NaisuXu/NUC980DKxxYx_Development_Board/NUC980DKxxYx_Development_Board.kicad_pcb

## KiCad design NUC980DKxxYx_Development_Board.kicad_pcb (2023-09-10)

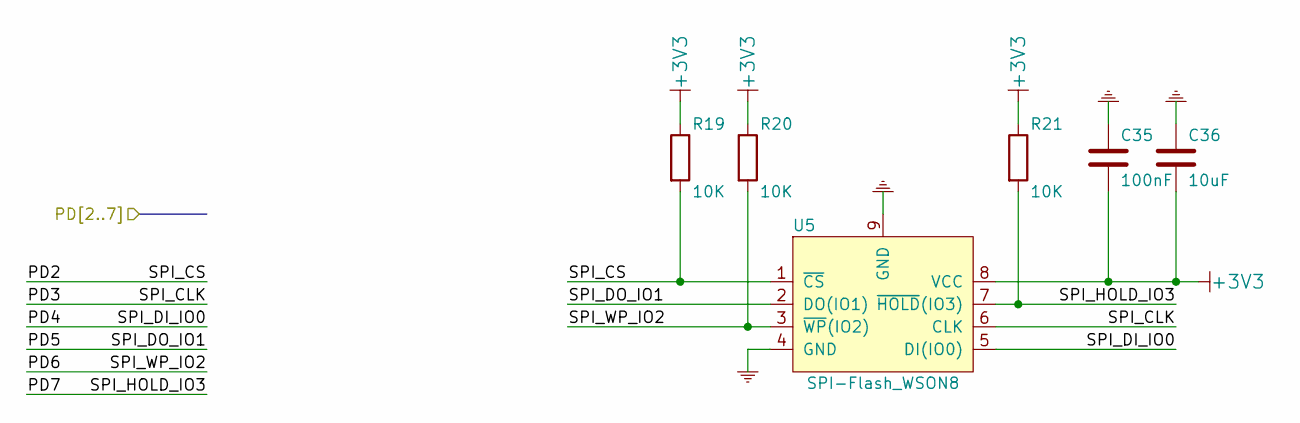
[picture p3: schematic SPI_Flash.kicad_sch]

Parts:
C35: 100nF; C_0603_1608Metric
C36: 10uF; C_0805_2012Metric
R19, R20, R21: 10K; R_0603_1608Metric
U5: SPI-Flash_WSON8; WSON-8-1EP_8x6mm_P1.27mm_EP3.4x4.3mm

Connections:
+3V3: C35.2, C36.2, R19.1, R20.1, R21.1, U5.8 (VCC); also elsewhere on the board
/PD2: R19.2, U5.1 (~CS); also elsewhere on the board
/PD3: U5.6 (CLK); also elsewhere on the board
/PD4: U5.5 (DI(IO0)); also elsewhere on the board
/PD5: U5.2 (DO(IO1)); also elsewhere on the board
/PD6: R20.2, U5.3 (~WP(IO2)); also elsewhere on the board
/PD7: R21.2, U5.7 (~HOLD(IO3)); also elsewhere on the board
GND: C35.1, C36.1, U5.4 (GND), U5.9 (GND); also elsewhere on the board

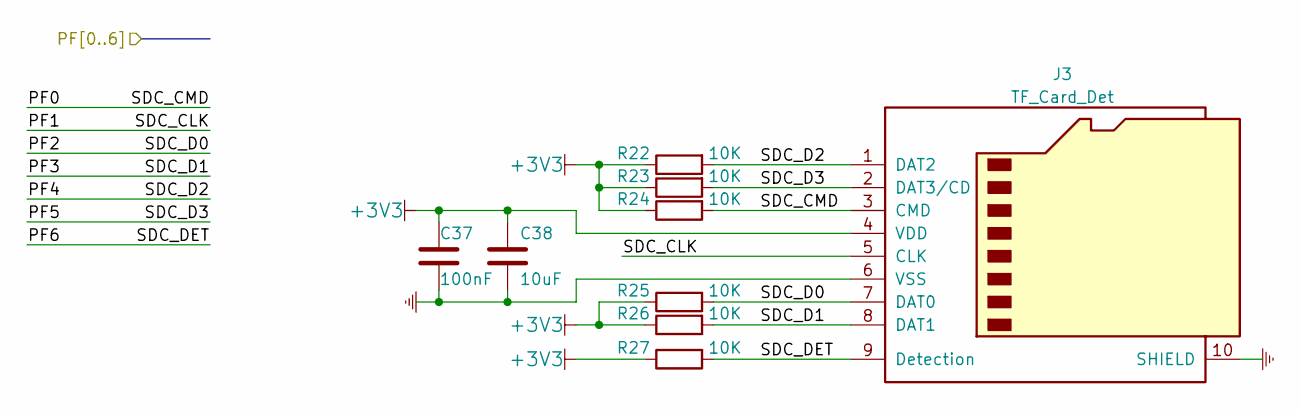
[picture p4: schematic SD_Card.kicad_sch]

Parts:
C37: 100nF; C_0603_1608Metric
C38: 10uF; C_0805_2012Metric
J3: TF_Card_Det; microSD_Push-Push_9P_4Pad
R22, R23, R24, R25, R26, R27: 10K; R_0603_1608Metric

Connections:
+3V3: C37.1, C38.1, J3.4 (VDD), R22.1, R23.1, R24.1, R25.1, R26.1, R27.1; also elsewhere on the board
/PF0: J3.3 (CMD), R24.2; also elsewhere on the board
/PF1: J3.5 (CLK); also elsewhere on the board
/PF2: J3.7 (DAT0), R25.2; also elsewhere on the board
/PF3: J3.8 (DAT1), R26.2; also elsewhere on the board
/PF4: J3.1 (DAT2), R22.2; also elsewhere on the board
/PF5: J3.2 (DAT3/CD), R23.2; also elsewhere on the board
/PF6: J3.9 (Detection), R27.2; also elsewhere on the board
GND: C37.2, C38.2, J3.6 (VSS), J3.10 (SHIELD); also elsewhere on the board

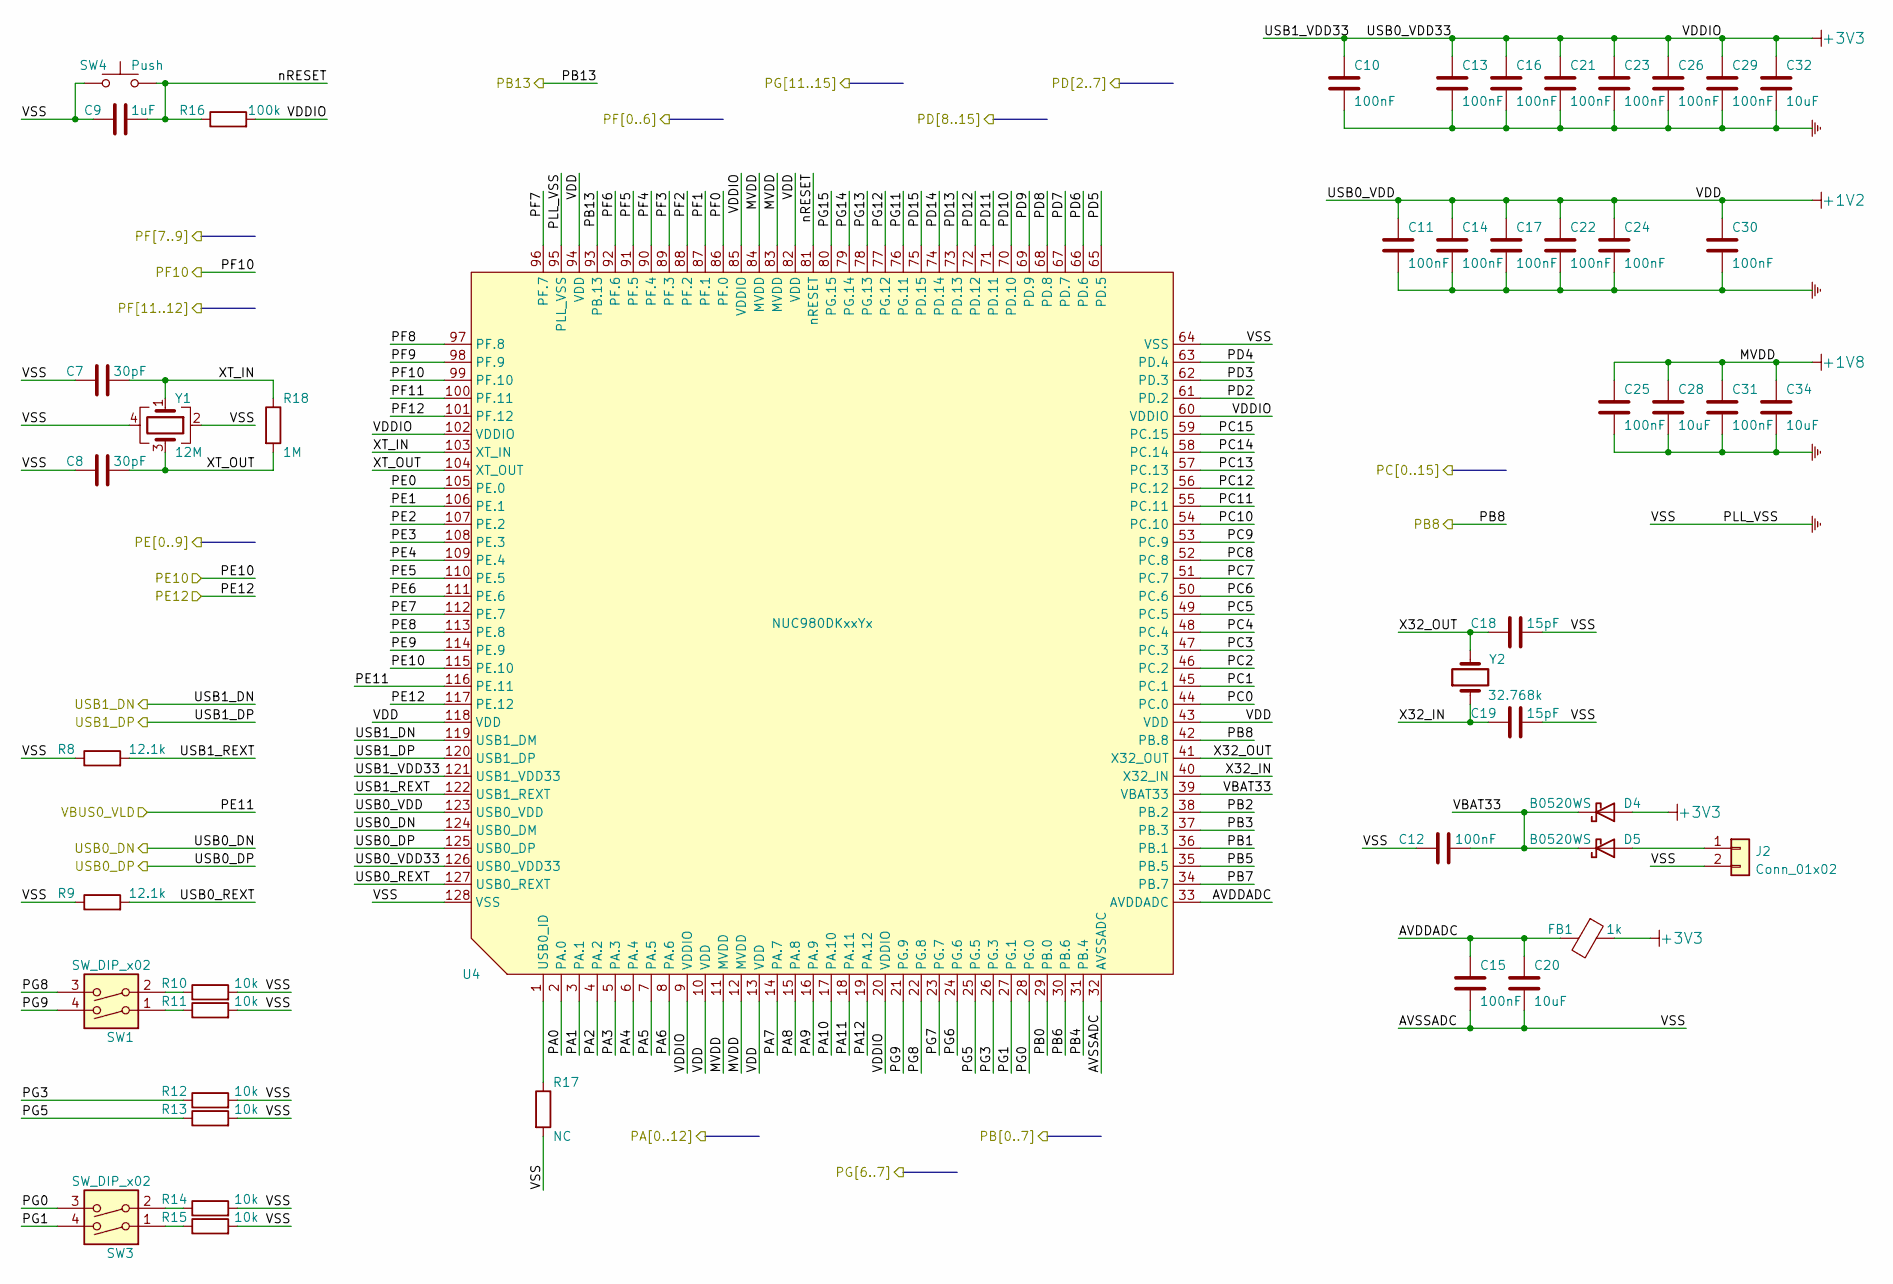
[picture p5: schematic MPU.kicad_sch]

Parts:
C7, C8: 30pF; C_0603_1608Metric
C9: 1uF; C_0603_1608Metric
C10, C11, C12, C13, C14, C15, C16, C17, C21, C22, C23, C24, C25, C26, C29, C30, C31: 100nF; C_0603_1608Metric
C18, C19: 15pF; C_0603_1608Metric
C20, C28, C32, C34: 10uF; C_0805_2012Metric
D4, D5: B0520WS; D_SOD-323
FB1: 1k; L_0603_1608Metric
J2: Conn_01x02; PinHeader_1x02_P2.54mm_Vertical
R8, R9: 12.1k; R_0603_1608Metric
R10, R11, R12, R13, R14, R15: 10k; R_0603_1608Metric
R16: 100k; R_0603_1608Metric
R17: NC; R_0603_1608Metric
R18: 1M; R_0603_1608Metric
SW1, SW3: SW_DIP_x02; SW_DIP_SPSTx02_Slide_9.78x7.26mm_W7.62mm_P2.54mm
SW4: Push; SW_SPST_CK_RS282G05A3
U4: NUC980DKxxYx; LQFP-128_14x14mm_P0.4mm
Y1: 12M; Crystal_SMD_3225-4Pin_3.2x2.5mm
Y2: 32.768k; Crystal_SMD_3215-2Pin_3.2x1.5mm

Connections:
+1V2: C11.1, C14.1, C17.1, C22.1, C24.1, C30.1, U4.10 (VDD), U4.13 (VDD), U4.43 (VDD), U4.82 (VDD), U4.94 (VDD), U4.118 (VDD), U4.123 (USB0_VDD); also elsewhere on the board
+1V8: C25.1, C28.1, C31.1, C34.1, U4.11 (MVDD), U4.12 (MVDD), U4.83 (MVDD), U4.84 (MVDD); also elsewhere on the board
+3V3: C10.1, C13.1, C16.1, C21.1, C23.1, C26.1, C29.1, C32.1, D4.2 (A), FB1.1, R16.2, U4.9 (VDDIO), U4.20 (VDDIO), U4.60 (VDDIO), U4.85 (VDDIO), U4.102 (VDDIO), U4.121 (USB1_VDD33), U4.126 (USB0_VDD33); also elsewhere on the board
/MPU/AVDDADC: C15.1, C20.1, FB1.2, U4.33 (AVDDADC)
/MPU/PG0: SW3.3, U4.28 (PG.0)
/MPU/PG1: SW3.4, U4.27 (PG.1)
/MPU/PG3: R12.1, U4.26 (PG.3)
/MPU/PG5: R13.1, U4.25 (PG.5)
/MPU/PG8: SW1.3, U4.22 (PG.8)
/MPU/PG9: SW1.4, U4.21 (PG.9)
/MPU/USB0_REXT: R9.2, U4.127 (USB0_REXT)
/MPU/USB1_REXT: R8.2, U4.122 (USB1_REXT)
/MPU/VBAT33: C12.2, D4.1 (K), D5.1 (K), U4.39 (VBAT33)
/MPU/X32_IN: C19.1, U4.40 (X32_IN), Y2.1
/MPU/X32_OUT: C18.1, U4.41 (X32_OUT), Y2.2
/MPU/XT_IN: C7.2, R18.1, U4.103 (XT_IN), Y1.1
/MPU/XT_OUT: C8.2, R18.2, U4.104 (XT_OUT), Y1.3
/MPU/nRESET: C9.2, R16.1, SW4.1, U4.81 (nRESET)
/PA0: U4.2 (PA.0); also elsewhere on the board
/PA1: U4.3 (PA.1); also elsewhere on the board
/PA2: U4.4 (PA.2); also elsewhere on the board
/PA3: U4.5 (PA.3); also elsewhere on the board
/PA4: U4.6 (PA.4); also elsewhere on the board
/PA5: U4.7 (PA.5); also elsewhere on the board
/PA6: U4.8 (PA.6); also elsewhere on the board
/PA7: U4.14 (PA.7); also elsewhere on the board
/PA8: U4.15 (PA.8); also elsewhere on the board
/PA9: U4.16 (PA.9); also elsewhere on the board
/PA10: U4.17 (PA.10); also elsewhere on the board
/PA11: U4.18 (PA.11); also elsewhere on the board
/PA12: U4.19 (PA.12); also elsewhere on the board
/PB0: U4.29 (PB.0); also elsewhere on the board
/PB1: U4.36 (PB.1); also elsewhere on the board
/PB2: U4.38 (PB.2); also elsewhere on the board
/PB3: U4.37 (PB.3); also elsewhere on the board
/PB4: U4.31 (PB.4); also elsewhere on the board
/PB5: U4.35 (PB.5); also elsewhere on the board
/PB6: U4.30 (PB.6); also elsewhere on the board
/PB7: U4.34 (PB.7); also elsewhere on the board
/PB8: U4.42 (PB.8); also elsewhere on the board
/PB13: U4.93 (PB.13); also elsewhere on the board
/PC0: U4.44 (PC.0); also elsewhere on the board
/PC1: U4.45 (PC.1); also elsewhere on the board
/PC2: U4.46 (PC.2); also elsewhere on the board
/PC3: U4.47 (PC.3); also elsewhere on the board
/PC4: U4.48 (PC.4); also elsewhere on the board
/PC5: U4.49 (PC.5); also elsewhere on the board
/PC6: U4.50 (PC.6); also elsewhere on the board
/PC7: U4.51 (PC.7); also elsewhere on the board
/PC8: U4.52 (PC.8); also elsewhere on the board
/PC9: U4.53 (PC.9); also elsewhere on the board
/PC10: U4.54 (PC.10); also elsewhere on the board
/PC11: U4.55 (PC.11); also elsewhere on the board
/PC12: U4.56 (PC.12); also elsewhere on the board
/PC13: U4.57 (PC.13); also elsewhere on the board
/PC14: U4.58 (PC.14); also elsewhere on the board
/PC15: U4.59 (PC.15); also elsewhere on the board
/PD2: U4.61 (PD.2); also elsewhere on the board
/PD3: U4.62 (PD.3); also elsewhere on the board
/PD4: U4.63 (PD.4); also elsewhere on the board
/PD5: U4.65 (PD.5); also elsewhere on the board
/PD6: U4.66 (PD.6); also elsewhere on the board
/PD7: U4.67 (PD.7); also elsewhere on the board
/PD8: U4.68 (PD.8); also elsewhere on the board
/PD9: U4.69 (PD.9); also elsewhere on the board
/PD10: U4.70 (PD.10); also elsewhere on the board
/PD11: U4.71 (PD.11); also elsewhere on the board
/PD12: U4.72 (PD.12); also elsewhere on the board
/PD13: U4.73 (PD.13); also elsewhere on the board
/PD14: U4.74 (PD.14); also elsewhere on the board
/PD15: U4.75 (PD.15); also elsewhere on the board
/PE0: U4.105 (PE.0); also elsewhere on the board
/PE1: U4.106 (PE.1); also elsewhere on the board
/PE2: U4.107 (PE.2); also elsewhere on the board
/PE3: U4.108 (PE.3); also elsewhere on the board
/PE4: U4.109 (PE.4); also elsewhere on the board
/PE5: U4.110 (PE.5); also elsewhere on the board
/PE6: U4.111 (PE.6); also elsewhere on the board
/PE7: U4.112 (PE.7); also elsewhere on the board
/PE8: U4.113 (PE.8); also elsewhere on the board
/PE9: U4.114 (PE.9); also elsewhere on the board
/PE10: U4.115 (PE.10); also elsewhere on the board
/PE12: U4.117 (PE.12); also elsewhere on the board
/PF0: U4.86 (PF.0); also elsewhere on the board
/PF1: U4.87 (PF.1); also elsewhere on the board
/PF2: U4.88 (PF.2); also elsewhere on the board
/PF3: U4.89 (PF.3); also elsewhere on the board
/PF4: U4.90 (PF.4); also elsewhere on the board
/PF5: U4.91 (PF.5); also elsewhere on the board
/PF6: U4.92 (PF.6); also elsewhere on the board
/PF7: U4.96 (PF.7); also elsewhere on the board
/PF8: U4.97 (PF.8); also elsewhere on the board
/PF9: U4.98 (PF.9); also elsewhere on the board
/PF10: U4.99 (PF.10); also elsewhere on the board
/PF11: U4.100 (PF.11); also elsewhere on the board
/PF12: U4.101 (PF.12); also elsewhere on the board
/PG6: U4.24 (PG.6); also elsewhere on the board
/PG7: U4.23 (PG.7); also elsewhere on the board
/PG11: U4.76 (PG.11); also elsewhere on the board
/PG12: U4.77 (PG.12); also elsewhere on the board
/PG13: U4.78 (PG.13); also elsewhere on the board
/PG14: U4.79 (PG.14); also elsewhere on the board
/PG15: U4.80 (PG.15); also elsewhere on the board
/USB0_DN: U4.124 (USB0_DM); also elsewhere on the board
/USB0_DP: U4.125 (USB0_DP); also elsewhere on the board
/USB1_DN: U4.119 (USB1_DM); also elsewhere on the board
/USB1_DP: U4.120 (USB1_DP); also elsewhere on the board
/VBUS0_VLD: U4.116 (PE.11); also elsewhere on the board
GND: C7.1, C8.1, C9.1, C10.2, C11.2, C12.1, C13.2, C14.2, C15.2, C16.2, C17.2, C18.2, C19.2, C20.2, C21.2, C22.2, C23.2, C24.2, C25.2, C26.2, C28.2, C29.2, C30.2, C31.2, C32.2, C34.2, J2.2, R8.1, R9.1, R10.2, R11.2, R12.2, R13.2, R14.2, R15.2, R17.2, SW4.2, U4.32 (AVSSADC), U4.64 (VSS), U4.95 (PLL_VSS), U4.128 (VSS), Y1.2, Y1.4; also elsewhere on the board
unnamed: D5.2 (A), J2.1
unnamed: R10.1, SW1.2
unnamed: R11.1, SW1.1
unnamed: R14.1, SW3.2
unnamed: R15.1, SW3.1
unnamed: R17.1, U4.1 (USB0_ID)

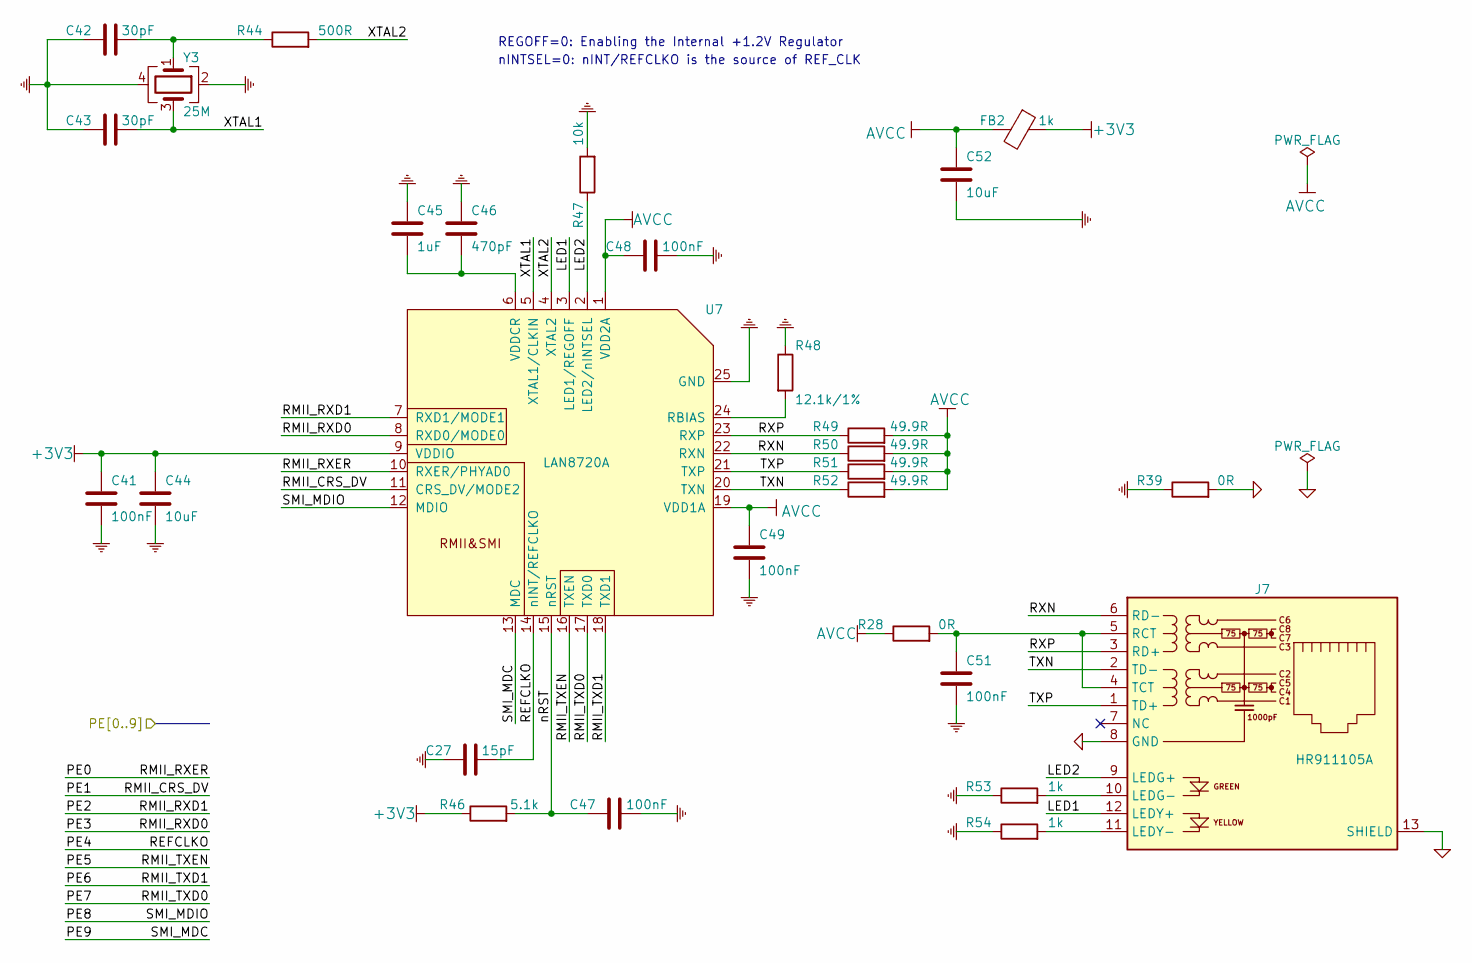
[picture p6: schematic RMII_ETH.kicad_sch]

Parts:
C27: 15pF; C_0603_1608Metric
C41, C47, C48, C49, C51: 100nF; C_0603_1608Metric
C42, C43: 30pF; C_0603_1608Metric
C44, C52: 10uF; C_0805_2012Metric
C45: 1uF; C_0603_1608Metric
C46: 470pF; C_0603_1608Metric
FB2: 1k; L_0603_1608Metric
J7: HR911105A
R28, R39: 0R; R_0603_1608Metric
R44: 500R; R_0603_1608Metric
R46: 5.1k; R_0603_1608Metric
R47: 10k; R_0603_1608Metric
R48: 12.1k/1%; R_0603_1608Metric
R49, R50, R51, R52: 49.9R; R_0603_1608Metric
R53, R54: 1k; R_0603_1608Metric
U7: LAN8720A; QFN-24-1EP_4x4mm_P0.5mm_EP2.4x2.4mm
Y3: 25M; Crystal_SMD_3225-4Pin_3.2x2.5mm

Connections:
+3V3: C41.1, C44.1, FB2.1, R46.1, U7.9 (VDDIO); also elsewhere on the board
/PE0: U7.10 (RXER/PHYAD0); also elsewhere on the board
/PE1: U7.11 (CRS_DV/MODE2); also elsewhere on the board
/PE2: U7.7 (RXD1/MODE1); also elsewhere on the board
/PE3: U7.8 (RXD0/MODE0); also elsewhere on the board
/PE4: C27.2, U7.14 (nINT/REFCLKO); also elsewhere on the board
/PE5: U7.16 (TXEN); also elsewhere on the board
/PE6: U7.18 (TXD1); also elsewhere on the board
/PE7: U7.17 (TXD0); also elsewhere on the board
/PE8: U7.12 (MDIO); also elsewhere on the board
/PE9: U7.13 (MDC); also elsewhere on the board
/RMII_ETH/LED1: J7.12 (LEDY+), U7.3 (LED1/REGOFF)
/RMII_ETH/LED2: J7.9 (LEDG+), R47.1, U7.2 (LED2/nINTSEL)
/RMII_ETH/RXN: J7.6 (RD-), R50.1, U7.22 (RXN)
/RMII_ETH/RXP: J7.3 (RD+), R49.1, U7.23 (RXP)
/RMII_ETH/TXN: J7.2 (TD-), R52.1, U7.20 (TXN)
/RMII_ETH/TXP: J7.1 (TD+), R51.1, U7.21 (TXP)
/RMII_ETH/XTAL1: C43.2, U7.5 (XTAL1/CLKIN), Y3.3
/RMII_ETH/XTAL2: R44.2, U7.4 (XTAL2)
/RMII_ETH/nRST: C47.1, R46.2, U7.15 (nRST)
GND: C27.1, C41.2, C42.1, C43.1, C44.2, C45.1, C46.1, C47.2, C48.2, C49.2, C51.2, C52.2, R39.1, R47.2, R48.1, R53.1, R54.1, U7.25 (GND), Y3.2, Y3.4; also elsewhere on the board
GNDA: J7.8 (GND), J7.13 (SHIELD), R39.2
unnamed: C42.2, R44.1, Y3.1
unnamed: C45.2, C46.2, U7.6 (VDDCR)
unnamed: C51.1, J7.4 (TCT), J7.5 (RCT), R28.2
unnamed: J7.10 (LEDG-), R53.2
unnamed: J7.11 (LEDY-), R54.2
unnamed: R48.2, U7.24 (RBIAS)
VCC: C48.1, C49.1, C52.1, FB2.2, R28.1, R49.2, R50.2, R51.2, R52.2, U7.1 (VDD2A), U7.19 (VDD1A)

Notes on the sheet:
REGOFF=0: Enabling the Internal +1.2V Regulator
nINTSEL=0: nINT/REFCLKO is the source of REF_CLK

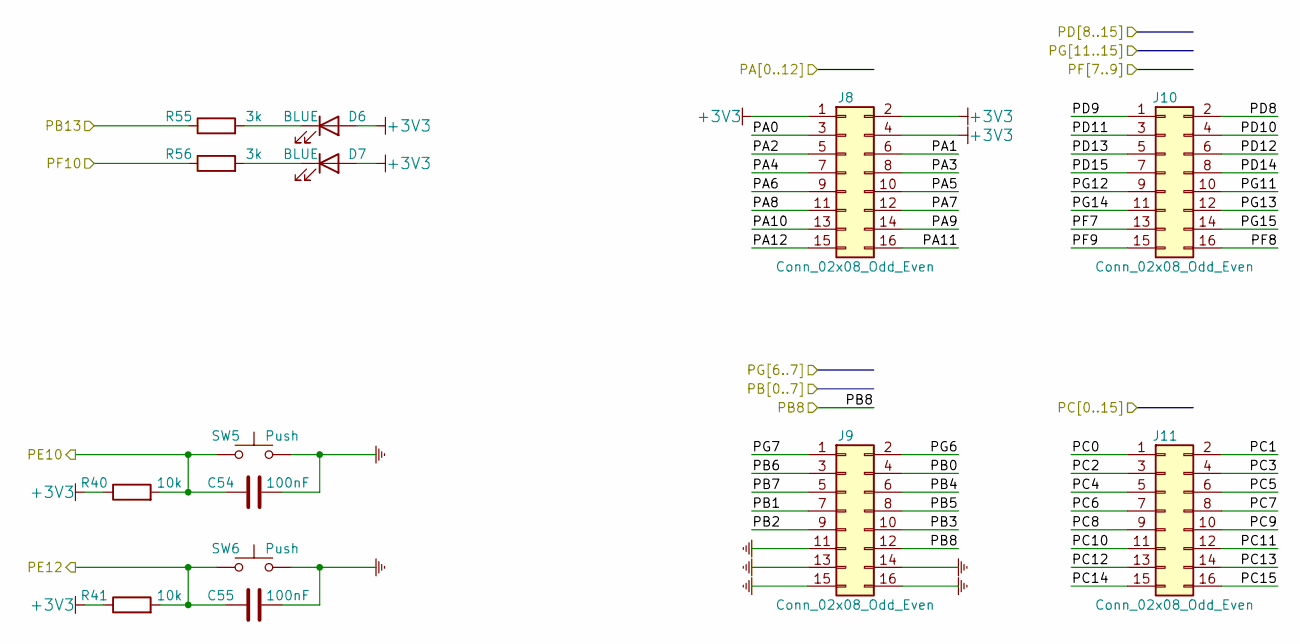
[picture p7: schematic Remaining_IO.kicad_sch]

Parts:
C54, C55: 100nF; C_0603_1608Metric
D6, D7: BLUE; LED_0603_1608Metric
J8, J9, J10, J11: Conn_02x08_Odd_Even; PinHeader_2x08_P2.54mm_Vertical
R40, R41: 10k; R_0603_1608Metric
R55, R56: 3k; R_0603_1608Metric
SW5, SW6: Push; SW_SPST_CK_RS282G05A3

Connections:
+3V3: D6.2 (A), D7.2 (A), J8.1, J8.2, J8.4, R40.1, R41.1; also elsewhere on the board
/PA0: J8.3; also elsewhere on the board
/PA1: J8.6; also elsewhere on the board
/PA2: J8.5; also elsewhere on the board
/PA3: J8.8; also elsewhere on the board
/PA4: J8.7; also elsewhere on the board
/PA5: J8.10; also elsewhere on the board
/PA6: J8.9; also elsewhere on the board
/PA7: J8.12; also elsewhere on the board
/PA8: J8.11; also elsewhere on the board
/PA9: J8.14; also elsewhere on the board
/PA10: J8.13; also elsewhere on the board
/PA11: J8.16; also elsewhere on the board
/PA12: J8.15; also elsewhere on the board
/PB0: J9.4; also elsewhere on the board
/PB1: J9.7; also elsewhere on the board
/PB2: J9.9; also elsewhere on the board
/PB3: J9.10; also elsewhere on the board
/PB4: J9.6; also elsewhere on the board
/PB5: J9.8; also elsewhere on the board
/PB6: J9.3; also elsewhere on the board
/PB7: J9.5; also elsewhere on the board
/PB8: J9.12; also elsewhere on the board
/PB13: R55.1; also elsewhere on the board
/PC0: J11.1; also elsewhere on the board
/PC1: J11.2; also elsewhere on the board
/PC2: J11.3; also elsewhere on the board
/PC3: J11.4; also elsewhere on the board
/PC4: J11.5; also elsewhere on the board
/PC5: J11.6; also elsewhere on the board
/PC6: J11.7; also elsewhere on the board
/PC7: J11.8; also elsewhere on the board
/PC8: J11.9; also elsewhere on the board
/PC9: J11.10; also elsewhere on the board
/PC10: J11.11; also elsewhere on the board
/PC11: J11.12; also elsewhere on the board
/PC12: J11.13; also elsewhere on the board
/PC13: J11.14; also elsewhere on the board
/PC14: J11.15; also elsewhere on the board
/PC15: J11.16; also elsewhere on the board
/PD8: J10.2; also elsewhere on the board
/PD9: J10.1; also elsewhere on the board
/PD10: J10.4; also elsewhere on the board
/PD11: J10.3; also elsewhere on the board
/PD12: J10.6; also elsewhere on the board
/PD13: J10.5; also elsewhere on the board
/PD14: J10.8; also elsewhere on the board
/PD15: J10.7; also elsewhere on the board
/PE10: C54.1, R40.2, SW5.2; also elsewhere on the board
/PE12: C55.1, R41.2, SW6.2; also elsewhere on the board
/PF7: J10.13; also elsewhere on the board
/PF8: J10.16; also elsewhere on the board
/PF9: J10.15; also elsewhere on the board
/PF10: R56.1; also elsewhere on the board
/PG6: J9.2; also elsewhere on the board
/PG7: J9.1; also elsewhere on the board
/PG11: J10.10; also elsewhere on the board
/PG12: J10.9; also elsewhere on the board
/PG13: J10.12; also elsewhere on the board
/PG14: J10.11; also elsewhere on the board
/PG15: J10.14; also elsewhere on the board
GND: C54.2, C55.2, J9.11, J9.13, J9.14, J9.15, J9.16, SW5.1, SW6.1; also elsewhere on the board
unnamed: D6.1 (K), R55.2
unnamed: D7.1 (K), R56.2

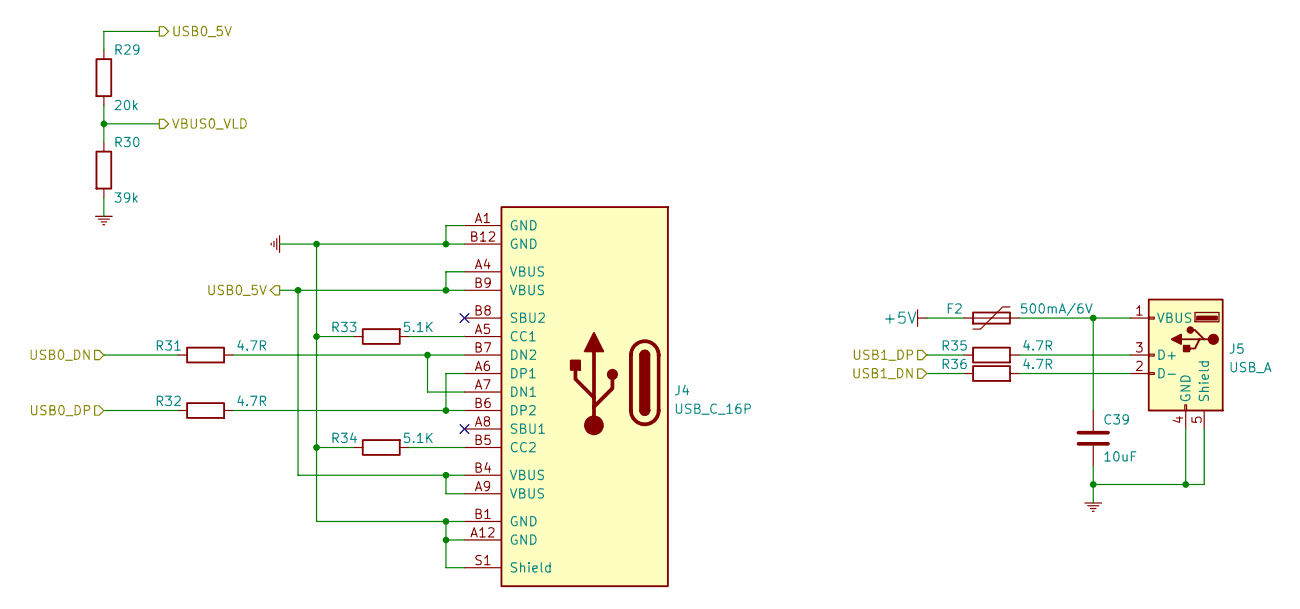
[picture p8: schematic USB.kicad_sch]

Parts:
C39: 10uF; C_0805_2012Metric
F2: 500mA/6V; Fuse_1206_3216Metric_Pad1.42x1.75mm_HandSolder
J4: USB_C_16P; USB_C_16P_4Foot8.64mm
J5: USB_A; USB_A_90Deg_THT_Horizontal
R29: 20k; R_0603_1608Metric
R30: 39k; R_0603_1608Metric
R31, R32, R35, R36: 4.7R; R_0603_1608Metric
R33, R34: 5.1K; R_0603_1608Metric

Connections:
+5V: F2.1; also elsewhere on the board
/USB0_5V: J4.A4 (VBUS), J4.A9 (VBUS), J4.B4 (VBUS), J4.B9 (VBUS), R29.1; also elsewhere on the board
/USB0_DN: R31.1; also elsewhere on the board
/USB0_DP: R32.1; also elsewhere on the board
/USB1_DN: R36.1; also elsewhere on the board
/USB1_DP: R35.1; also elsewhere on the board
/VBUS0_VLD: R29.2, R30.1; also elsewhere on the board
GND: C39.2, J4.A1 (GND), J4.A12 (GND), J4.B1 (GND), J4.B12 (GND), J4.S1 (Shield), J5.4 (GND), J5.5 (Shield), R30.2, R33.1, R34.1; also elsewhere on the board
unnamed: C39.1, F2.2, J5.1 (VBUS)
unnamed: J4.A5 (CC1), R33.2
unnamed: J4.A6 (DP1), J4.B6 (DP2), R32.2
unnamed: J4.A7 (DN1), J4.B7 (DN2), R31.2
unnamed: J4.B5 (CC2), R34.2
unnamed: J5.2 (D-), R36.2
unnamed: J5.3 (D+), R35.2

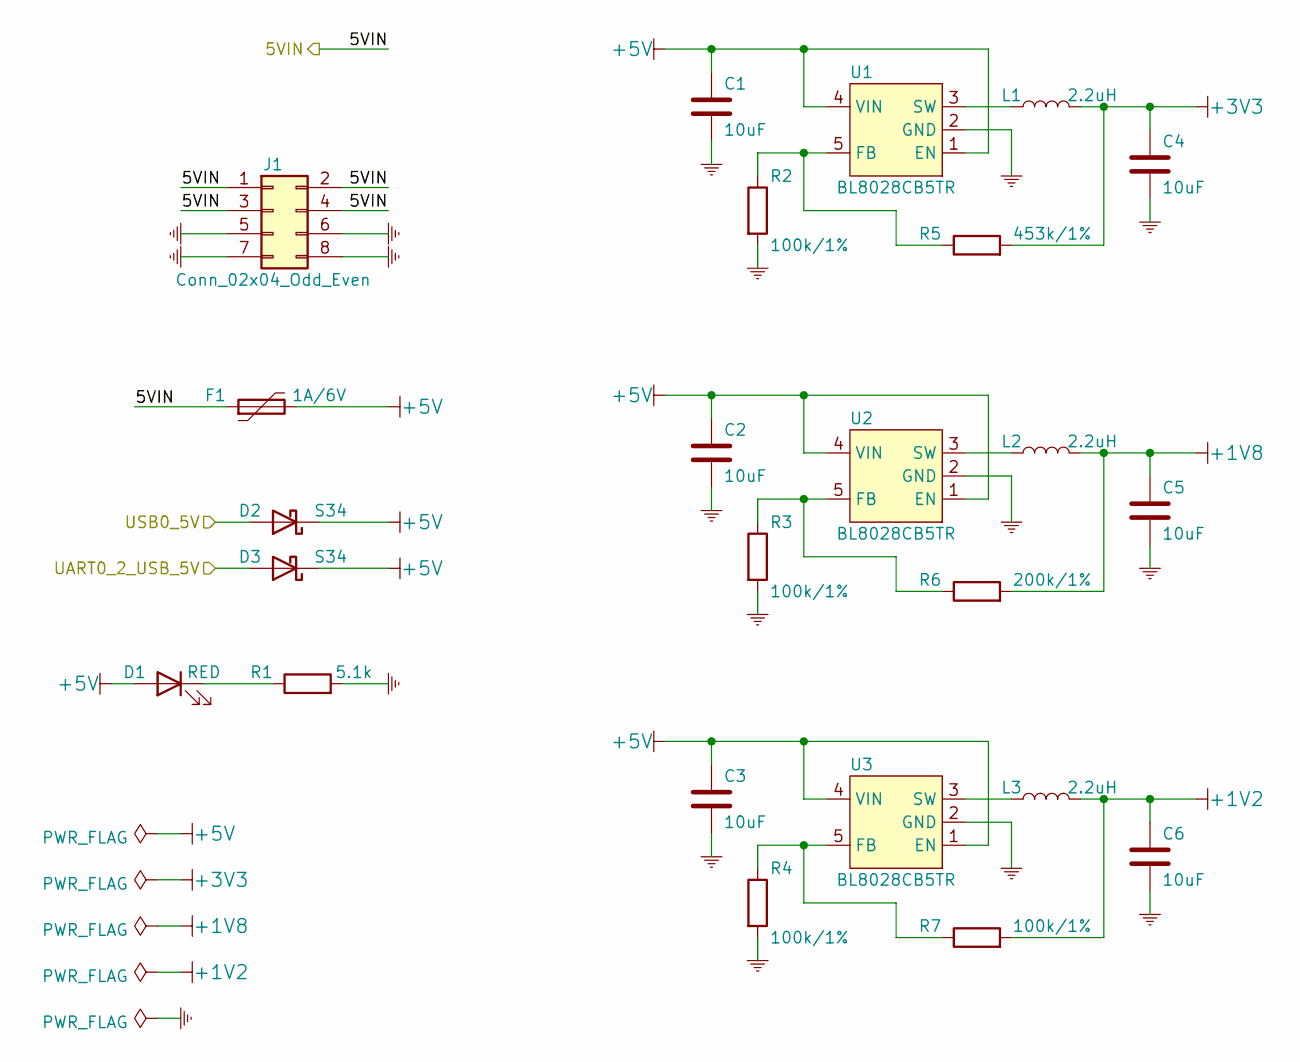
[picture p9: schematic Power.kicad_sch]

Parts:
C1, C2, C3, C4, C5, C6: 10uF; C_0805_2012Metric
D1: RED; LED_0603_1608Metric
D2, D3: S34; D_SOD-123F
F1: 1A/6V; Fuse_1206_3216Metric_Pad1.42x1.75mm_HandSolder
J1: Conn_02x04_Odd_Even; PinHeader_2x04_P2.54mm_Vertical
L1, L2, L3: 2.2uH; Inductor_SMD_2520_2.5x2.0mm
R1: 5.1k; R_0603_1608Metric
R2, R3, R4, R7: 100k/1%; R_0603_1608Metric
R5: 453k/1%; R_0603_1608Metric
R6: 200k/1%; R_0603_1608Metric
U1, U2, U3: BL8028CB5TR; SOT-23-5

Connections:
+1V2: C6.1, L3.2, R7.2; also elsewhere on the board
+1V8: C5.1, L2.2, R6.2; also elsewhere on the board
+3V3: C4.1, L1.2, R5.2; also elsewhere on the board
+5V: C1.1, C2.1, C3.1, D1.2 (A), D2.1 (K), D3.1 (K), F1.2, U1.1 (EN), U1.4 (VIN), U2.1 (EN), U2.4 (VIN), U3.1 (EN), U3.4 (VIN); also elsewhere on the board
/5VIN: F1.1, J1.1, J1.2, J1.3, J1.4
/UART0_2_USB_5V: D3.2 (A); also elsewhere on the board
/USB0_5V: D2.2 (A); also elsewhere on the board
GND: C1.2, C2.2, C3.2, C4.2, C5.2, C6.2, J1.5, J1.6, J1.7, J1.8, R1.2, R2.2, R3.2, R4.2, U1.2 (GND), U2.2 (GND), U3.2 (GND); also elsewhere on the board
unnamed: D1.1 (K), R1.1
unnamed: L1.1, U1.3 (SW)
unnamed: L2.1, U2.3 (SW)
unnamed: L3.1, U3.3 (SW)
unnamed: R2.1, R5.1, U1.5 (FB)
unnamed: R3.1, R6.1, U2.5 (FB)
unnamed: R4.1, R7.1, U3.5 (FB)

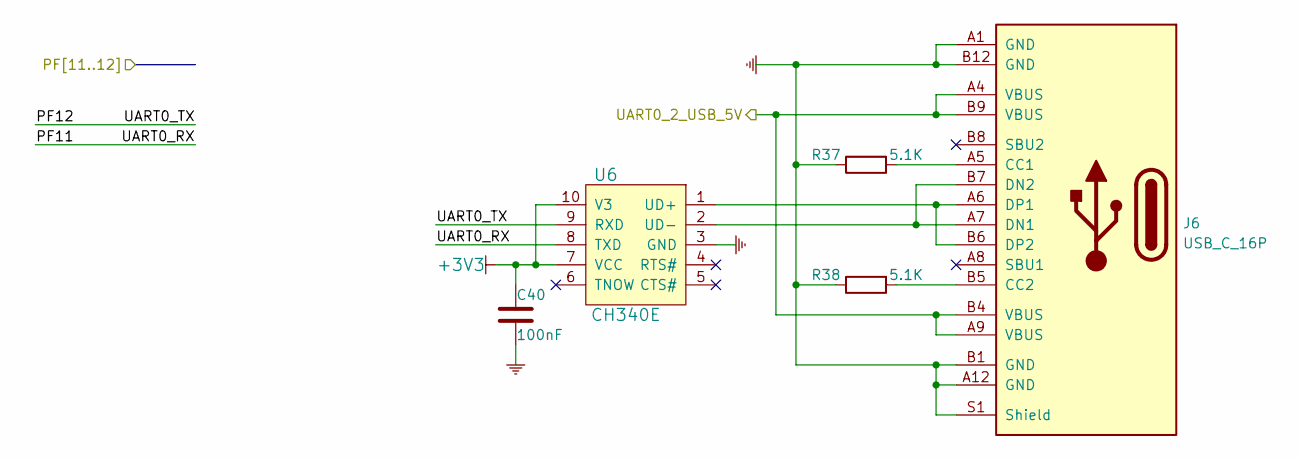
[picture p10: schematic UART0_2_USB.kicad_sch]

Parts:
C40: 100nF; C_0603_1608Metric
J6: USB_C_16P; USB_C_16P_4Foot8.64mm
R37, R38: 5.1K; R_0603_1608Metric
U6: CH340E; MSOP-10_3x3mm_P0.5mm

Connections:
+3V3: C40.1, U6.7 (VCC), U6.10 (V3); also elsewhere on the board
/PF11: U6.8 (TXD); also elsewhere on the board
/PF12: U6.9 (RXD); also elsewhere on the board
/UART0_2_USB_5V: J6.A4 (VBUS), J6.A9 (VBUS), J6.B4 (VBUS), J6.B9 (VBUS); also elsewhere on the board
GND: C40.2, J6.A1 (GND), J6.A12 (GND), J6.B1 (GND), J6.B12 (GND), J6.S1 (Shield), R37.1, R38.1, U6.3 (GND); also elsewhere on the board
unnamed: J6.A5 (CC1), R37.2
unnamed: J6.A6 (DP1), J6.B6 (DP2), U6.1 (UD+)
unnamed: J6.A7 (DN1), J6.B7 (DN2), U6.2 (UD-)
unnamed: J6.B5 (CC2), R38.2

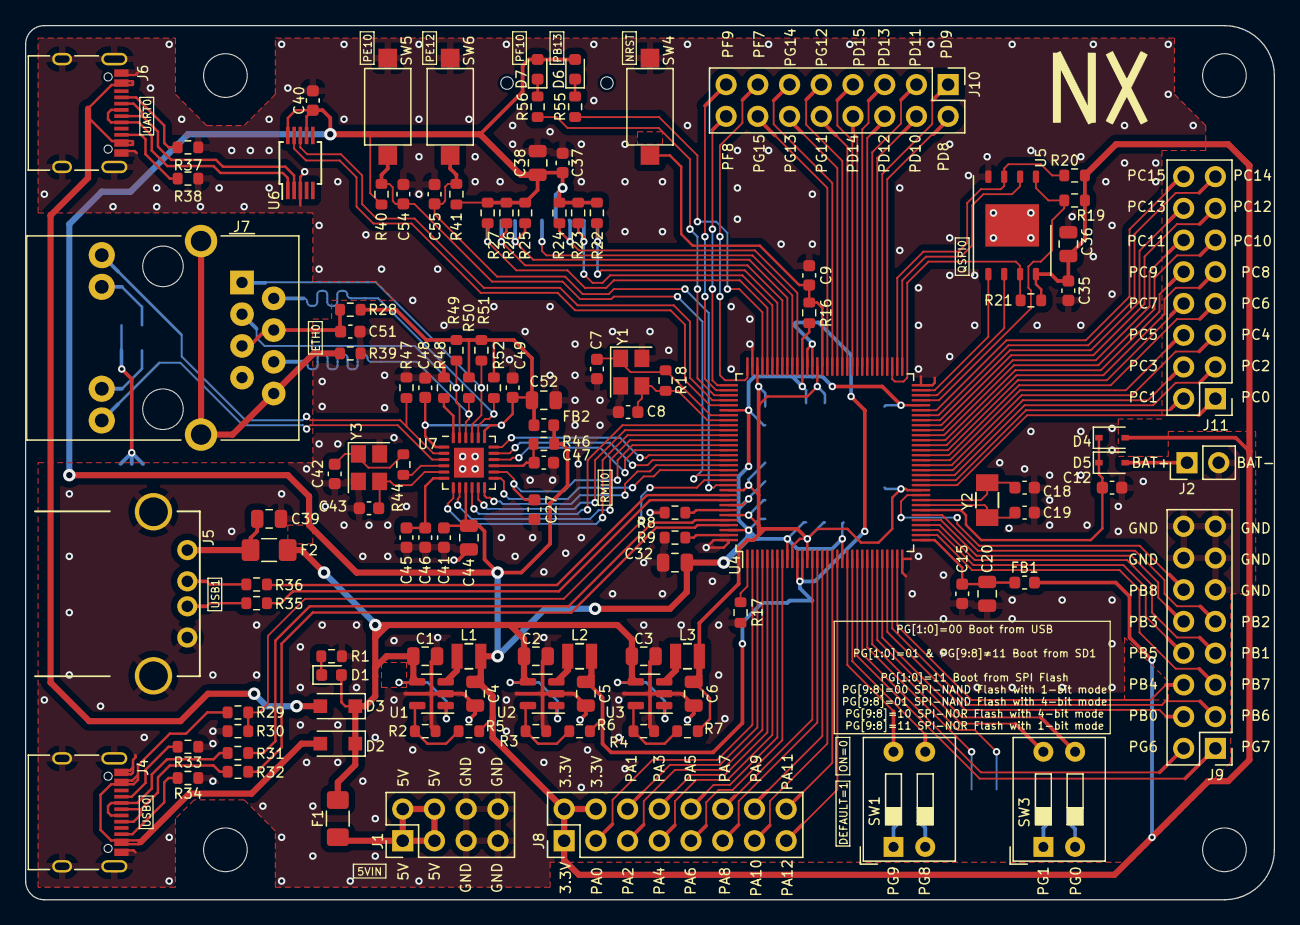
[picture p11: board NUC980DKxxYx_Development_Board.kicad_pcb from above]

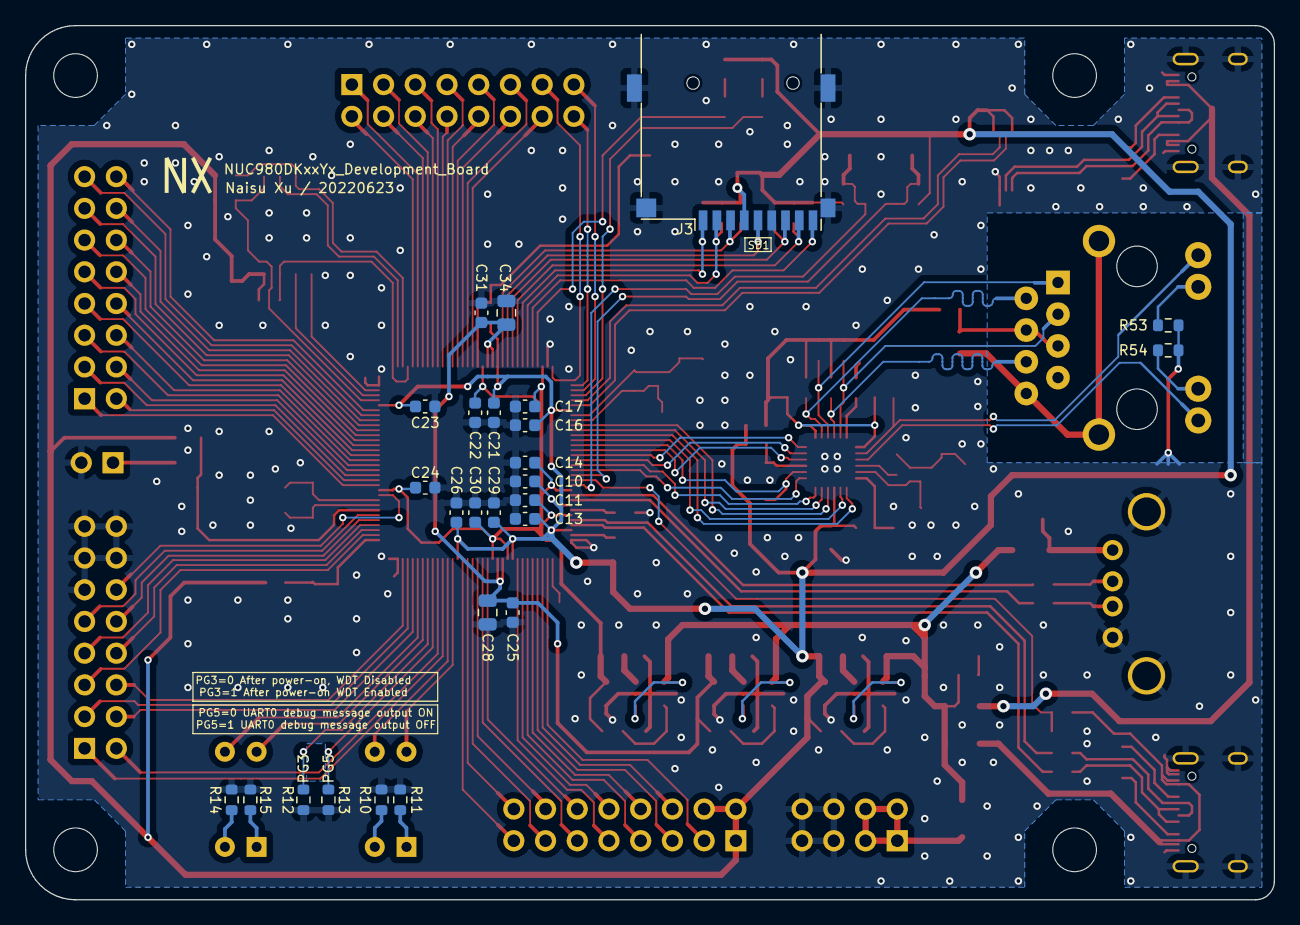
[picture p12: board NUC980DKxxYx_Development_Board.kicad_pcb from below]

Board: 2 copper layers, 100.0 x 70.0 mm, 145 parts (26 on the bottom side), 156 nets.
