NaisuXu/NUC980DKxxYx_Development_Board/(commit log)

2022-06-27 feat: first commit.
    [MPU.kicad_sch, NUC980DKxxYx_Development_Board.kicad_pcb, NUC980DKxxYx_Development_Board.kicad_sch, Power.kicad_sch, RMII_ETH.kicad_sch, Remaining_IO.kicad_sch, SD_Card.kicad_sch, SPI_Flash.kicad_sch]
2023-09-10 modeify: update to kicad 7.0
    [MPU.kicad_sch, NUC980DKxxYx_Development_Board.kicad_pcb, NUC980DKxxYx_Development_Board.kicad_sch, Power.kicad_sch, RMII_ETH.kicad_sch, Remaining_IO.kicad_sch, SD_Card.kicad_sch, SPI_Flash.kicad_sch]
